HolTyc/Smart_basement/Documentation/Dokumentace.odt

Dokumentace k chytrému sklepu

Vypracoval: Jan Holý

Komunikace:

Zapojení:

- Všechny Atmegy jsou propojeny 3 kabely – SPI0.
  - Tahle komunikace se používá na jejich následné programování Raspberry pi zero (dále jen „Zero“).
  - Také se používá na posílání dat mezi jednotlivými Atmegami.
  - Dále se používá na komunikaci Main Atmegy (dále jen „Main“) s bezdrátovým modulem nRF24L01.
- Všechny Atmegy jsou propojeny jedním kabelem jménem SafePin, který při nahrávání kódu zastaví všechnu komunikaci.
- Main je propojená se Zero pomocí USART.
- Main je přípojená pomocí MasterOrder kabelu do Interface Atmega (dále jen „Interface“).
- Zero komunikuje se čtečkou čipů (RFID-RC522) pomocí SPI1.

Vysvělení komunikací:

- SPI0
  - Programování Atmeg pomocí Zero.
  - Posílání dat z Sensor Atmega(dále jen „Sensor“) do Main.
  - Interface po vynucení (viz MasterOrder) odešle zmáčknuté tlačítko na numpadu Main. (Tahle komunikace je ze všech nejsložitější, jelikož po výběru na numpadu se z Main musí jěště poslat do Interface data senzorů.)
  - Main komunikuje s bezdrátovým modulem nRF24L01.
- SPI1
  - Komunikace čtečky čipů se Zero – soubory na práci s RFID-RC522 se nachází ve složce pi-rfid.
- SafePin (GPIO4)
  - Pokud je na GPIO4 1, tak Atmegy přestanou komunikovat.
  - Pokud je na GPIO4 0, tak Atmegy mohou bez problému komunikovat.
- USART
  - Základní USART komunikace mezi Main a Zero – soubory na komunikace se nachází ve složce Arduino_Programming/pythonCode.
- MasterOrder
  - Kabel slouží k vynucení komunikace Main s Interface.
  - Pokud je MasterOrder 1, tak Interface chce komunikovat s Main.
  - Pokud je MasterOrder 0, tak Interface nechce komunikovat s Main.

Programování Atmeg:

- Atmegy jsou programovány v klasickém .ino formátu.
- Knihovny se nachází ve stejné složce jako kód a jsou importovány pomocí apostrofů.
- Pro programování se používá skript uploadFileIno.sh.
  - Ukázka použití skriptu: $ sudo ./uploadFileIno.sh 1 masterATmega1 nebo $ sudo ./uploadFileIno.sh master masterATmega1.
  - Skript nahradí v avrdude.conf reset pin na adekvátní pin Atmegy.

Zaloha:

- Cesta zálohy je /share/homes/Moje_slozky/RaspberryPi.

Plošný spoj názvy:

PCB | Název
U1 | Main Atmega
U2 | Sensor Atmega
U3 | Interface Atmega
RR1 | 10K – reset resistor Main
RR2 | 10K – reset resistor Sensor
RR3 | 10K – reset resistor Interface
DR1 | 10k - DHT22 resistor
R1-R12 | 220
C1-C6 | 30p – krystal resistory
MPCX | Main Atmega PCX
MData1 | Main Atmega Data - PD2
MSafe1 | Main Atmega Safe LED - PD4
SSafe1 | Sensor Atmega Safe LED – PD2
SData1 | Sensor Atmega Data LED - PB0
IData1 | Interface Atmega Data LED - PC0
ISafe1 | Interface Atmega Safe LED - PC3
Num1 | Num pad Interface
Power1 | Napajeni pomoci 5V
LCD1 | Lcd konektor
RFID1 | RFID konektro
Rasp_pins1 | Volne piny Raspberry pi pro rele
X1-X3 | 16Mhz – Atmega krystal
V1 | Volne piny sensor atmegy
NRF1 | NRF24L01
Zero1 | Raspberry Pi zero
