HolTyc/Smart_basement/Documentation/Navod.docx

https://pimylifeup.com/raspberry-pi-rfid-rc522/

https://pimylifeup.com/raspberry-pi-rfid-attendance-system/

https://grafana.com/tutorials/install-grafana-on-raspberry-pi/
