HolTyc/Smart_basement/PCB/Chytry_sklep/Chytry_sklep.kicad_pcb

## KiCad design PCB/Chytry_sklep/Chytry_sklep.kicad_pcb (2025-03-22)

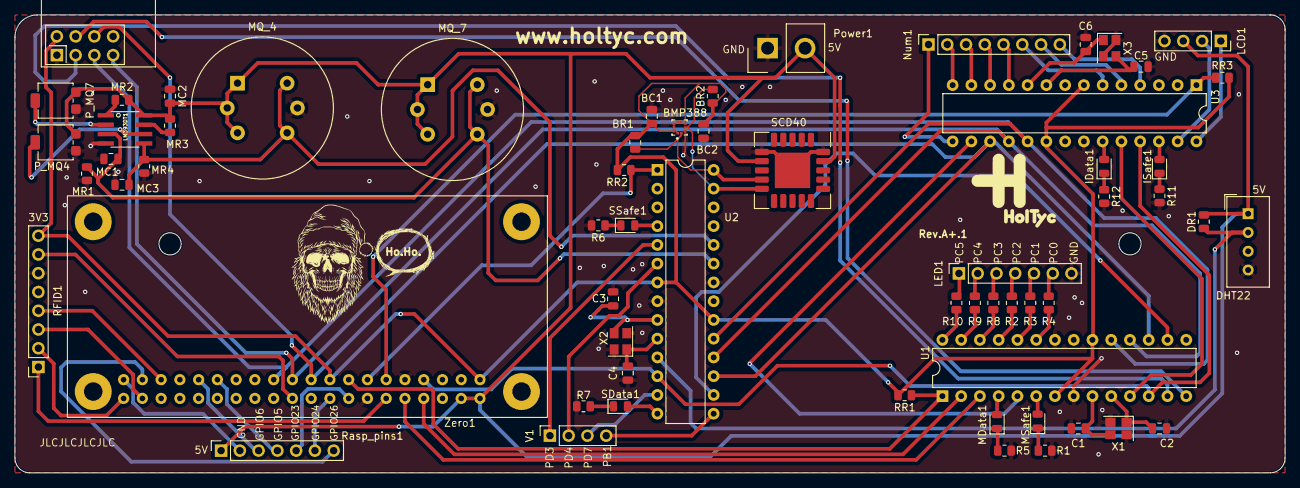
[picture p5: board Chytry_sklep.kicad_pcb from above]

Board: 2 copper layers, 172.0 x 62.0 mm, 62 parts (0 on the bottom side), 81 nets.

Parts:
BC1, BC2: 100nF; C_0805_2012Metric
BMP388: BMP388
BR1, BR2: 4.7K; R_0805_2012Metric
C1, C2, C3, C4, C5, C6: 10p; C_0805_2012Metric
DHT22: DHT11; Aosong_DHT11_5.5x12.0_P2.54mm
DR1: 10k; R_0805_2012Metric
IData1: LED; LED_0805_2012Metric
ISafe1: LED; LED_0805_2012Metric
LCD1: Conn_01x04_Pin; PinSocket_1x04_P2.54mm_Vertical
LED1: Conn_01x07; PinSocket_1x07_P2.54mm_Vertical
LM393DT1: 0; LM393DT
MC1, MC2, MC3: 100nF; C_0805_2012Metric
MData1: LED; LED_0805_2012Metric
MQ_4: MQ-4; MQ-6
MQ_7: MQ-7; MQ-6
MR1, MR2, MR3, MR4: 10K; R_0805_2012Metric
MSafe1: LED; LED_0805_2012Metric
NRF1: NRF24L01_Breakout; nRF24L01_Breakout
Num1: Conn_01x08_Pin; PinSocket_1x08_P2.54mm_Vertical
P_MQ4, P_MQ7: TC33X-2-103E; Potentiometer_Bourns_3314G_Vertical
Power1: Conn_01x02_Pin; Samtec_HPM-02-01-x-S_Straight_1x02_Pitch5.08mm
R1, R2, R3, R4, R5, R6, R7, R8, R9, R10, R11, R12: 220; R_0805_2012Metric
RFID1: Conn_01x08_Pin; PinSocket_1x08_P2.54mm_Vertical
RR1, RR2, RR3: 10k; R_0805_2012Metric
Rasp_pins1: Conn_01x07_Pin; PinSocket_1x07_P2.54mm_Vertical
SCD40: SCD40-D-R2; Sensirion_SCD4x-1EP_10.1x10.1mm_P1.25mm_EP4.8x4.8mm
SData1: LED; LED_0805_2012Metric
SSafe1: LED; LED_0805_2012Metric
U1, U2, U3: ATmega328-P; DIP-28_W7.62mm
V1: Volne_sensor; PinSocket_1x04_P2.54mm_Vertical
X1, X2, X3: 16Mhz; Crystal_SMD_3225-4Pin_3.2x2.5mm
Zero1: Raspberry_Pi_2_3; RaspberryPi_zero

Connections:
+3.3V: BC1.2, BC2.1, BMP388.1 (VDDIO), BMP388.5 (SDO), BMP388.10 (VDD), BR1.2, BR2.1, NRF1.2 (VCC), RFID1.8, RR1.2, RR2.2, RR3.2, U1.7 (VCC), U1.20 (AVCC), U2.7 (VCC), U2.20 (AVCC), U3.7 (VCC), U3.20 (AVCC), Zero1.1 (3V3), Zero1.17 (3V3)
+5V: DHT22.1 (VCC), DR1.2, LCD1.3, LM393DT1.8 (VCC), MC2.2, MQ_4.1 (B1), MQ_4.2 (VH+), MQ_4.3 (B2), MQ_7.1 (B1), MQ_7.2 (VH+), MQ_7.3 (B2), MR2.1, MR3.2, P_MQ4.1, P_MQ7.1, Power1.2, Rasp_pins1.1, SCD40.7 (VDD), SCD40.19 (VDD), Zero1.2 (5V), Zero1.4 (5V)
/Atmega_interface/CE_interface: U1.5 (PD3), U3.16 (PB2)
/Atmega_interface/Master_order: U1.11 (PD5), U3.24 (PC1)
/Atmega_interface/RST: RR3.1, U3.1 (~RESET/PC6), Zero1.11 (GPIO17)
/Atmega_interface/Safe_pin: U1.12 (PD6), U2.12 (PD6), U3.25 (PC2), Zero1.7 (GCLK0/GPIO4)
/Atmega_master/CE_sensor: U1.16 (PB2), U2.16 (PB2)
/Atmega_master/RST: RR1.1, U1.1 (~RESET/PC6), Zero1.15 (GPIO22)
/Atmega_sensor/RST: RR2.1, U2.1 (~RESET/PC6), Zero1.13 (GPIO27)
/RX: U1.2 (PD0), Zero1.8 (GPIO14/TXD)
/TX: U1.3 (PD1), Zero1.10 (GPIO15/RXD)
CE: NRF1.3 (CE), U1.13 (PD7)
CSN: NRF1.4 (~CSN), U1.14 (PB0)
D3: U2.5 (PD3), V1.1
D4: U2.6 (PD4), V1.2
D7: U2.13 (PD7), V1.3
D9: U2.15 (PB1), V1.4
GND: BC1.1, BC2.2, BMP388.3 (VSS), BMP388.8 (VSS), BMP388.9 (VSS), C1.1, C2.2, C3.2, C4.2, C5.2, C6.2, DHT22.4 (GND), LCD1.4, LED1.7, LM393DT1.4 (GND), MC1.1, MC2.1, MC3.1, MQ_4.5 (VH-), MQ_7.5 (VH-), MR1.2, MR4.2, NRF1.1 (GND), P_MQ4.3, P_MQ7.3, Power1.1, R1.2, R5.2, R6.2, R7.2, R11.2, R12.2, RFID1.6, SCD40.6 (GND), SCD40.20 (GND), SCD40.21 (GND), U1.8 (GND), U1.22 (GND), U2.8 (GND), U2.22 (GND), U3.8 (GND), U3.22 (GND), X1.2, X1.4, X2.2, X2.4, X3.2, X3.4, Zero1.9 (GND), Zero1.14 (GND)
GND1: Rasp_pins1.2, Zero1.39 (GND)
ISCL: LCD1.1, U3.28 (PC5)
ISDA: LCD1.2, U3.27 (PC4)
MISO: NRF1.7 (MISO), U1.18 (PB4), U2.18 (PB4), U3.18 (PB4), Zero1.21 (MISO0/GPIO9)
MOSI: NRF1.6 (MOSI), U1.17 (PB3), U2.17 (PB3), U3.17 (PB3), Zero1.19 (MOSI0/GPIO10)
MPC0: IData1.2 (A), U3.23 (PC0)
MQ_4_D: LM393DT1.5 (IN2+), MC3.2, MQ_4.4 (A2), MQ_4.6 (A1), MR4.1, U2.24 (PC1)
MQ_7_D: LM393DT1.3 (IN1+), MC1.2, MQ_7.4 (A2), MQ_7.6 (A1), MR1.1, U2.23 (PC0)
unnamed: DHT22.2 (IO), DR1.1, U2.11 (PD5)
unnamed: IData1.1 (K), R12.1
unnamed: ISafe1.2 (A), U3.26 (PC3)
unnamed: ISafe1.1 (K), R11.1
unnamed: LM393DT1.1 (OUT1), MR2.2
unnamed: LM393DT1.7 (OUT2), MR3.1
unnamed: MData1.2 (A), U1.4 (PD2)
unnamed: MData1.1 (K), R5.1
unnamed: MSafe1.2 (A), U1.6 (PD4)
unnamed: MSafe1.1 (K), R1.1
unnamed: Num1.1, U3.15 (PB1)
unnamed: Num1.2, U3.14 (PB0)
unnamed: Num1.3, U3.13 (PD7)
unnamed: Num1.4, U3.12 (PD6)
unnamed: Num1.5, U3.11 (PD5)
unnamed: Num1.6, U3.6 (PD4)
unnamed: Num1.7, U3.5 (PD3)
unnamed: Num1.8, U3.4 (PD2)
unnamed: RFID1.1, Zero1.12 (GPIO18/PWM0)
unnamed: RFID1.2, Zero1.40 (GPIO21/SCLK1)
unnamed: RFID1.3, Zero1.38 (GPIO20/MOSI1)
unnamed: RFID1.4, Zero1.35 (GPIO19/MISO1)
unnamed: RFID1.7, Zero1.22 (GPIO25)
unnamed: Rasp_pins1.3, Zero1.31 (GCLK2/GPIO6)
unnamed: Rasp_pins1.4, Zero1.29 (GCLK1/GPIO5)
unnamed: Rasp_pins1.5, Zero1.16 (GPIO23)
unnamed: Rasp_pins1.6, Zero1.18 (GPIO24)
unnamed: Rasp_pins1.7, Zero1.37 (GPIO26)
unnamed: SData1.2 (A), U2.14 (PB0)
unnamed: R7.1, SData1.1 (K)
unnamed: SSafe1.2 (A), U2.4 (PD2)
unnamed: R6.1, SSafe1.1 (K)
unnamed: R4.1, U1.23 (PC0)
unnamed: R3.1, U1.24 (PC1)
unnamed: R2.1, U1.25 (PC2)
unnamed: R8.1, U1.26 (PC3)
unnamed: R9.1, U1.27 (PC4)
unnamed: R10.1, U1.28 (PC5)
unnamed: C1.2, U1.9 (XTAL1/PB6), X1.3
unnamed: C2.1, U1.10 (XTAL2/PB7), X1.1
unnamed: C3.1, U2.9 (XTAL1/PB6), X2.3
unnamed: C4.1, U2.10 (XTAL2/PB7), X2.1
unnamed: C5.1, U3.9 (XTAL1/PB6), X3.3
unnamed: C6.1, U3.10 (XTAL2/PB7), X3.1
PC0: LED1.6, R4.2
PC1: LED1.5, R3.2
PC2: LED1.4, R2.2
PC3: LED1.3, R8.2
PC4: LED1.2, R9.2
PC5: LED1.1, R10.2
POT1: LM393DT1.2 (IN1-), P_MQ7.2
POT2: LM393DT1.6 (IN2-), P_MQ4.2
SCK: NRF1.5 (SCK), U1.19 (PB5), U2.19 (PB5), U3.19 (PB5), Zero1.23 (SCLK0/GPIO11)
SCL: BMP388.2 (SCK), BR1.1, SCD40.9 (SCL), U2.28 (PC5)
SDA: BMP388.4 (SDI), BR2.2, SCD40.10 (SDA), U2.27 (PC4)
