HolTyc/Smart_basement/Raspberry_pi/4_1_2025/home/hanzalt/Arduino_Programming/arduinoProgramming/sensorATmega2/MQ7.cpp

/*	
	MQ7.cpp
	Created by Fergus Baker
	22 August 2020
	Released into the public domain.
*/

#include "MQ7.h"
#include "Arduino.h"

float MQ7::readPpm() {
	return (float) _COEF_A0 * pow(
		readRs() / R0,
		_COEF_A1
	);
}

float MQ7::readRs() {
	return _LOAD_RES * readRsRL();
}

float MQ7::readRsRL() {
	float voltage = convertVoltage(
		analogRead(a_pin)
	);

	return (v_in - voltage) / voltage;
}

float MQ7::convertVoltage(int voltage) {
	// ATD conversion
	return (float) voltage * (v_in / 1023.0);
}

void MQ7::calibrate() {
	#ifndef _R0	// if no hardcoded R0 value

	for (int i = 0; i <= CALIBRATION_SECONDS; i++) {
		delay(1000);
		R0 = readRs() / _CALIBRATION_CONSTANT;
	}

	#endif		// end
}


float MQ7::getR0() {
	return R0;
}
