HolTyc/Smart_basement/(commit log)

2025-03-04 Revision A+ 1
    [00-default.cfg, Atmega_interface.kicad_sch, Atmega_master.kicad_sch, Atmega_sensor.kicad_sch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]
2025-03-22 Last old version
    Created SklepWan and starting to work on STM32 smart_basement and STM32 SklepWan Devboard
